LastZactionHero/pikkolo-mesh-stick/mesh/mesh.kicad_pcb

## KiCad design rf_transmitter-receiver_morse_code_HW/rf_transmitter-receiver_morse_code.kicad_sch

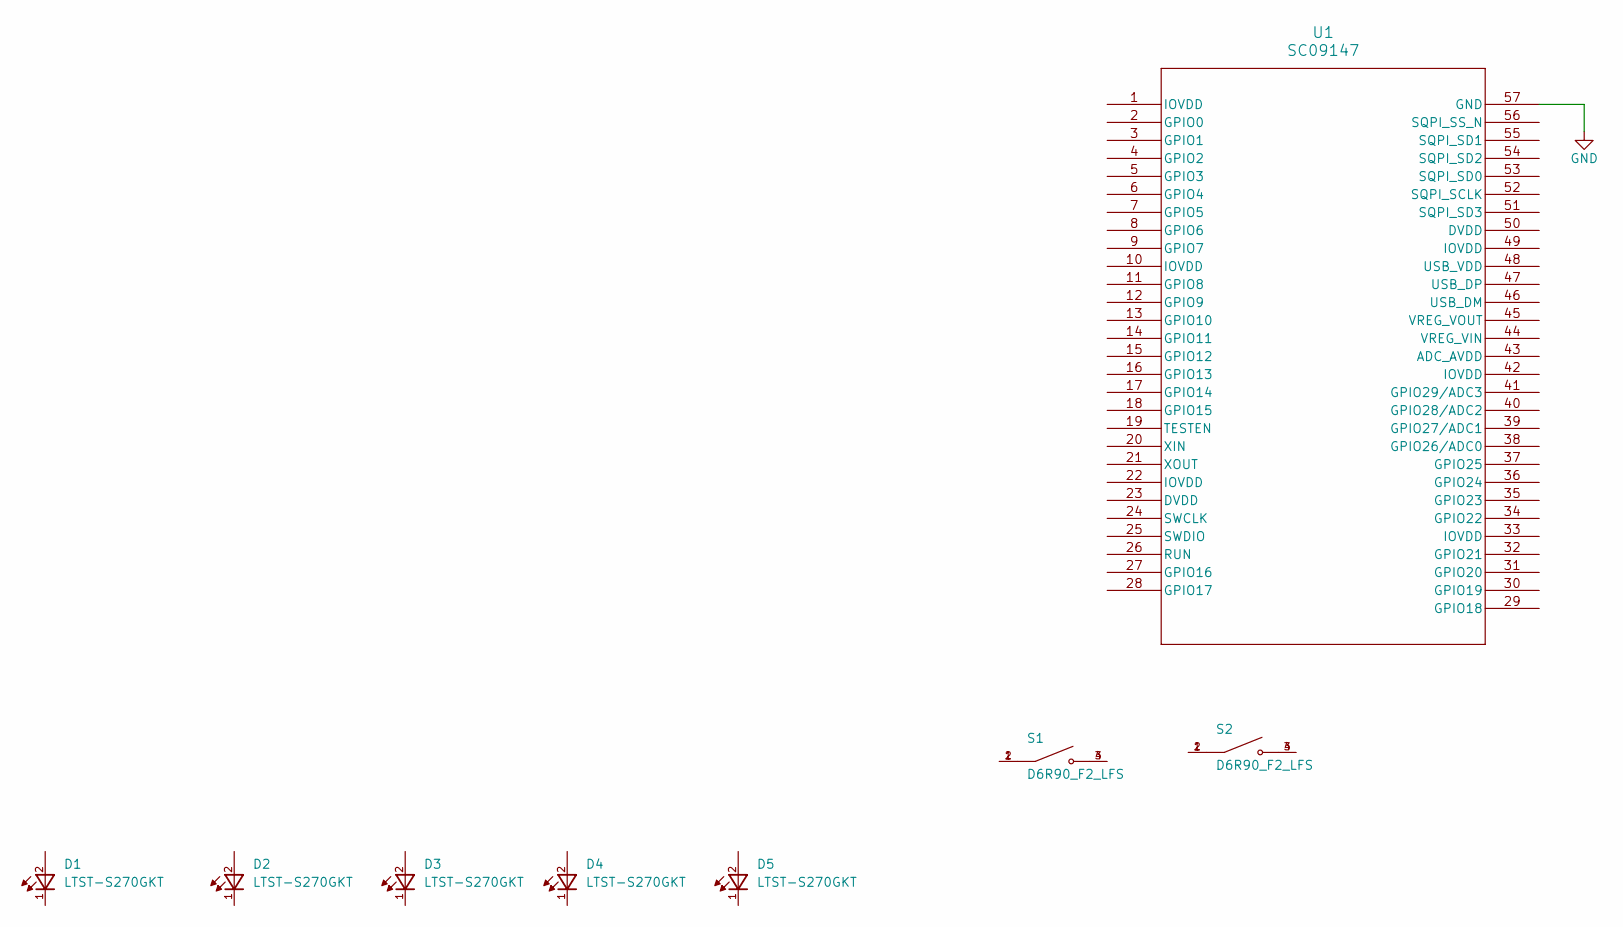
[picture p1: schematic rf_transmitter-receiver_morse_code.kicad_sch]

Parts:
D1, D2, D3, D4, D5: LTST-S270GKT; 0603
S1, S2: D6R90_F2_LFS; SW_D6R90_F2_LFS; PARTREV 21 Feb 22
U1: SC09147; QFN56_7X7_RPI

Connections:
GND: U1.57 (GND)
unnamed: S1.1, S1.2
unnamed: S1.3, S1.4
unnamed: S2.1, S2.2
unnamed: S2.3, S2.4
