LastZactionHero/pikkolo-mesh-stick/(commit log)

2026-08-23 Pikkolo Mesh Stick Rev A: verified schematic, generator, and personal KiCad library
    Schematic captured as code (mesh_design.py -> schlib.py -> mesh.kicad_sch), with
    netlist verification against intent. 87 placements, 61 nets, ERC clean.
    Includes findings that correct the draft BOM: the SK9822-EC20 2020 pinout is not
    APA102-compatible, the RF switch needs both DIO2 and GPIO17, the SS14 level-shift
    trick does not work, and stock Meshtastic firmware will not start this radio.
    [mesh.kicad_pcb, mesh.kicad_sch]
2026-08-23 Add design-check and BOM tooling, net classes, and EP-via footprints
    verify_netlist.py answers "did KiCad build the netlist I meant?". These add the
    other half.
    check_design.py checks the things ERC cannot see because they are about intent:
    a footprint that does not resolve in the library table, a net with one pin on it,
    an IC supply rail with no capacitor, a BOM line with no part number.
    bom.py groups by (value, footprint, MPN) the way an assembler does, because that
    grouping -- not the raw part count -- is what a fab charges setup for. Exports
    generic CSV or a JLCPCB assembly BOM.
    layout.py holds the drawing shapes that sit on top of schlib: a series chain whose
    parts butt together into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
    [bom.py, check_design.py, layout.py, project_setup.py]
2026-08-23 Rev B: USB-C plug, red-team fixes, and a schematic that reads as one
    USB-A edge fingers are gone; J2 is a real USB-C male plug. A sink presenting a
    plug terminates CC with a SINGLE Rd -- putting 5.1k on both CC and VCONN shows the
    host the Debug Accessory signature instead of a device. All four VBUS and all four
    GND contacts bus through. B6/B7, SBU and the SuperSpeed pads are deliberately
    unnetted, per Type-C R2.4 Table 3-11 notes 2 and 5.
    The plug is a straddle mount -- the A row lands on F.Cu, the B row on B.Cu, and the
    board edge becomes the plug's tongue -- so the CONNECTOR now sets the stack-up at
    0.8 mm. That is also what makes a 90 ohm USB pair and a sane 50 ohm RF line
    routable on a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
    [mesh.kicad_sch]
2026-08-23 Add a route-readiness gate, a decision record, and a pad-map check
    "Is this ready to route?" was a judgement call. Now it is a script.
    ready_to_route.py runs the narrower tools together -- verify_netlist ("is the netlist
    what I meant?"), check_design ("is that netlist a sane board?"), bom ("can I order
    it?") -- and adds the checks none of them cover: that every ERC warning is on an
    allow-list with a written reason, that every fitted BOM line has a part number, that
    net classes exist, and that no design decision is still open. Exit 0 only when every
    mechanical gate passes.
    The gates a script cannot close are printed too, by name: the RF network still has to
    be validated on a VNA or replaced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
    [check_design.py, mesh_design.py, ready_to_route.py]
2026-08-23 Rewrite the notes and README for Rev B
    Both documents still described Rev A: USB-A edge fingers, the SK9822 LED chain, a
    2.0 mm board, and a dual antenna feed. All four are gone, so the docs were not just
    stale but actively misleading — someone following them would have wired a connector
    that no longer exists.
    The notes now lead with the gate rather than with prose, record each Rev B change with
    the reason it was made, and list the six open decisions as a table rather than burying
    them in a "next steps" list. The red-team defects are a table of defect against fix, so
    it is possible to check the work rather than take it on faith.
    Also documented, because both cost real time to establish: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
2026-08-23 Adopt the Johanson IPD, go 4-layer, and fix two bugs Rev B introduced
    A fresh-eyes review found that the Rev B bulk-cap cut had created a defect. With the
    VBUS bulk trimmed to spec, FB1 was left driving only 2 uF: a 0.6-1.6 uH bead against
    2 uF is a 90-145 kHz tank damped only by its own DCR, and a hot-plug step rings 13-49%
    above 5 V -- past the LP5907's 6.0 V absolute maximum. The ferrite is deleted and both
    LDO inputs now sit on the node the ESD array actually clamps. That also closes
    DECISIONS['ferrite_fb1'].
    Second bug from the same change set: the I2C pads added for expansion had no pull-ups
    anywhere. I2C is open drain, so the bus could never be released high, and the RP2040's
    50-80k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
    [mesh.kicad_sch]
2026-08-23 Close the flash and antenna decisions, and source the BOM
    FLASH, respin class. The GD25Q32E accepts only a one-byte 01h Write Status Register.
    The RP2040's stock second stage issues 01h followed by TWO data bytes in one CS#
    assertion, which that datasheet says is not executed at all -- so the quad-enable bit
    stays 0, the EBh quad read returns garbage, and the chip faults out of boot2. The
    symptom is the nastiest kind available: the board enumerates as RPI-RP2 and happily
    accepts a UF2, then never runs.
    U3 becomes W25Q128JVSIQ. The Winbond "...IQ" order codes ship with QE already fixed to
    1 in silicon, so boot2's 35h check short-circuits and the offending write is never
    issued -- the bug cla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
    [mesh.kicad_sch]
2026-08-23 Fix the QFN paste apertures, respecify the LDO capacitors, and record the fab constraints
    The forked exposed-pad footprints had two manufacturability defects. Paste coverage was
    47.3% (RP2040) and 39.8% (SX1262), both under IPC-7093A's 50-60% band for a thermal
    land, and the apertures cleared the via barrels by 0.00 mm -- so paste would have wicked
    straight down the holes. Vias are now 0.50/0.30 mm, which is also exactly the project's
    0.10 mm minimum annular ring, and the apertures are retuned to 56.3% and 52.3% with
    0.05 mm and 0.03 mm of barrel clearance. They stay ordinary plated through holes: the
    fab's plugged-via rules exclude a via with a mask opening on either side, and the
    exposed p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
    [mesh.kicad_sch]
2026-08-23 Flash: W25Q32JVSSIQ, not W25Q128JVSIQ — and the sourcing objection checked
    Pushed back on the Winbond choice on the grounds that Winbond flash is impossible to
    find or discontinued, so I checked LCSC rather than argue:
    W25Q32JVSSIQ C179173 70,003 in stock $0.554 SOIC-8-208mil
    W25Q128JVSIQ C97521 ~95,000 $2.45 SOIC-8-208mil, JLCPCB Basic
    GD25Q32ESIGR 37,921 $0.906
    The scarcity does not hold for the JV generation. W25Q32JVSSIQ has nearly twice the
    stock of the GigaDevice part it replaces and costs 40% less, at the same 4 MB and the
    same 208-mil SOIC-8, with a pin-identical KiCad symbol.
    Where the objection does hold: the other RP2040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
    [mesh.kicad_sch]
2026-08-23 Antenna: a real right-angle SMA jack, and a correction to why edge launches were rejected
    The reason on file for avoiding a board-edge SMA was wrong. It said the Taoglas
    EMPCB.SMAFSTJ.B.HT "caps at 0.79 mm" against a fab that delivers 0.72-0.88 mm. Its
    specification table actually says 0.8 mm; only the footprint page says 0.79, and 0.79 mm
    IS 0.031 in -- the number the industry uses for a 0.8 mm board, not a machined cliff.
    Adafruit sell the same part class as "for 0.8mm / 0.031 Slim PCBs".
    The real objection is different, and it applies to every edge launch rather than to one
    part: tightening an SMA to its own spec torque of 0.57 N.m puts roughly 134 MPa of shear
    into a 20 x 0.8 mm FR-4 st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
    [mesh.kicad_sch]
2026-08-24 RP2354A: the flash moves into the package
    The owner asked twice for no second memory chip, so U1 becomes RP2354A -- an RP2350A die
    with a Winbond W25Q16JVWI 2 MB flash die stacked in the same QFN-60 package. U3 and its
    decoupling are gone, and so is the entire failure class that made us reject the
    GD25Q32E: a flash that accepts only a one-byte 01h status-register write cannot have its
    quad-enable bit set by the stock boot2, and the board would enumerate, accept a UF2, and
    never run. That cannot happen to a die Raspberry Pi qualified themselves.
    2 MB is enough, measured rather than assumed. Meshtastic's released pico2 image is
    978,688 B against 1,536 kB of sketch space with the standard 0.5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
    [mesh.kicad_sch]
2026-08-24 The sourcing gate stops demanding part numbers for fungible resistors
    A 1% thin-film 0402 at a given value is interchangeable across a dozen vendors, and
    value + package + tolerance already IS the complete purchase specification. Demanding an
    MPN for one was ceremony rather than engineering, and it was holding the last mechanical
    gate red over 470R, 4k7, 0R and 33R.
    Capacitors are deliberately NOT exempt. The RF ones are C0G at +/-0.1 pF and a generic
    X7R substitute would quietly detune the front end -- exactly the class of mistake a gate
    exists to catch. Everything else still has to name a part.
    The gate now prints the spec-bought values rather than hiding them, so the information is
    stil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
    [ready_to_route.py]
2026-08-24 Add a costed BOM: bom.py --cost, against a dated price file
    "What does this board cost" should be a command, not a spreadsheet somebody rebuilt by
    hand. prices.json carries unit price at qty 10 and 100 plus the LCSC minimum order
    quantity, with the snapshot date at the top so nobody trusts it a year from now.
    The report prints two numbers per build size and they are deliberately different: what
    the parts cost per board, and what the CART costs. On a ten-board run those diverge by
    $19.79 -- 19% of the order -- because most 0402 passives carry a 100-piece minimum, so a
    ten-board build buys a hundred of nearly everything and bins the rest. That gap is the
    whole reason line-item count matters m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
2026-08-24 Author the exact MPN3012S land rather than substituting a generic 3012
    L2's footprint was the one assignment still marked unverified: a generic 3012-size land
    standing in for a part whose drawing nobody had read. Pulled the manufacturer datasheet
    (LCSC C52024124) and transcribed the Recommended Land Pattern table -- a (gap) = 1.00,
    b (pad width) = 1.10, c (pad length) = 2.7, so pad centres sit at +/-1.05mm.
    None of KiCad's three stock 3012 lands actually matches it. L_Cenker_CKCS3012, which was
    assigned, has the right centres and the right pad length but 1.4mm-wide pads -- 0.3mm
    over spec, which closes the inter-pad gap from 1.00 to 0.70mm directly underneath a
    conductive metal-alloy body.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
    [mesh.kicad_sch]
2026-08-24 Add the placement floor plan for layout
    Six zones in signal-flow order, the two package rotations that make the routing
    fall out (U1 90 CCW so the buck/USB side faces the connector and SPI/crystal face
    the radio; U2 90 CW so the RF side faces FL1 and the TCXO sits above), the
    non-negotiable RF ground rules, the routing order, and the do-not list. Distilled
    from docs/SCHEMATIC-NOTES.md so the person doing layout has one sheet to work from.
    Claude-Session: https://claude.ai/code/session_01L6RoqgW9x4s4XgQCvcFbCH
2026-08-24 Make the project portable across machines, and prove it with doctor.py
    This is about to move back to the Mac it came from, and one thing in here would have
    broken on arrival: check_design.py hardcoded /usr/share/kicad/footprints and
    /usr/share/kicad/template. On macOS those live under KiCad.app/Contents/SharedSupport,
    so every footprint would have reported unresolvable and the route-readiness gate would
    have failed for a reason that has nothing to do with the design. Both are now derived
    from wherever schlib already found the stock symbols, which is the one place that knows.
    The ${KICAD*_TEMPLATE_DIR} substitution is regexed rather than string-matched on the
    version number too.
    doctor.py an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
    [check_design.py, doctor.py]
